icanc0/swarm-pcb/swarm-pcb.kicad_pcb

## KiCad design swarm-pcb.kicad_pcb (2024-11-10)

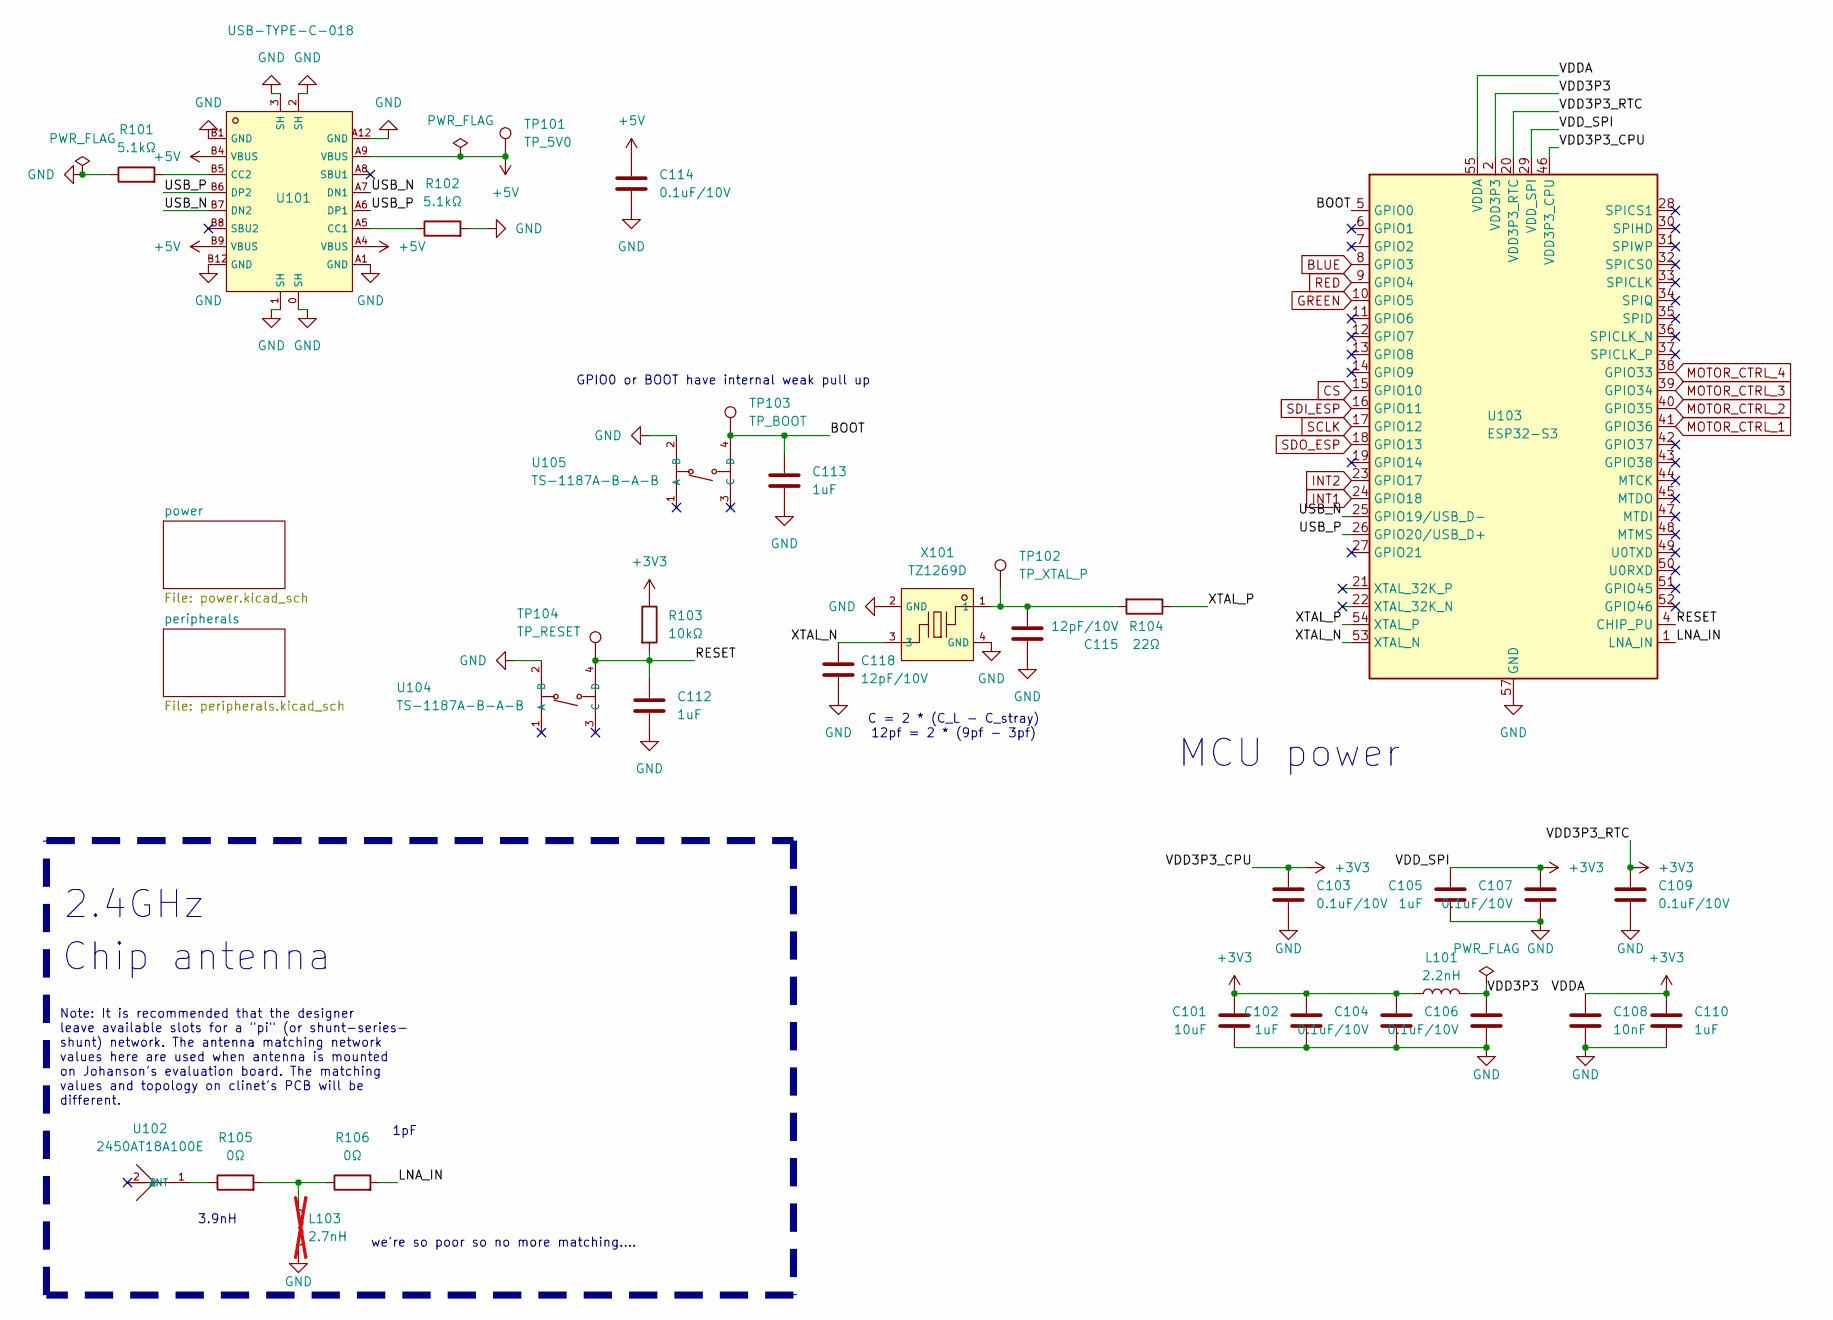
[picture p1: schematic swarm-pcb.kicad_sch]

Parts:
C101: 10uF; C_0603_1608Metric
C102, C105, C110, C112, C113: 1uF; C_0603_1608Metric
C103, C104, C106, C107, C109, C114: 0.1uF/10V; C_0402_1005Metric
C108: 10nF; C_0402_1005Metric
C115, C118: 12pF/10V; C_0603_1608Metric
L101: 2.2nH; L_0402_1005Metric
L103: 2.7nH; L_0402_1005Metric; not fitted
R101, R102: 5.1kΩ; R_0402_1005Metric
R103: 10kΩ; L_0402_1005Metric
R104: 22Ω; R_0402_1005Metric
R105, R106: 0Ω; R_0402_1005Metric
TP101: TP_5V0; Pin_D1.0mm_L10.0mm
TP102: TP_XTAL_P; Pin_D1.0mm_L10.0mm
TP103: TP_BOOT; Pin_D1.0mm_L10.0mm
TP104: TP_RESET; Pin_D1.0mm_L10.0mm
U101: USB-TYPE-C-018; USB-C_SMD-TYPE-C-31-M-12; LCSC C2927038
U102: 2450AT18A100E; ANT-SMD_L3.2-W1.6; LCSC C89334
U103: ESP32-S3; QFN-56-1EP_7x7mm_P0.4mm_EP4x4mm
U104, U105: TS-1187A-B-A-B; SW-SMD_4P-L5.1-W5.1-P3.70-LS6.5-TL-2; LCSC C318884
X101: TZ1269D; CRYSTAL-SMD_4P-L2.0-W1.6-BL-A; LCSC C501798

Connections:
+3V3: C101.1, C102.1, C103.1, C104.1, C105.1, C107.1, C108.1, C109.1, C110.1, L101.2, R103.1, U103.20 (VDD3P3_RTC), U103.29 (VDD_SPI), U103.46 (VDD3P3_CPU), U103.55 (VDDA), U103.56 (VDDA); also elsewhere on the board
+5V: C114.1, TP101.1, U101.A4 (VBUS), U101.A9 (VBUS), U101.B4 (VBUS), U101.B9 (VBUS); also elsewhere on the board
/BOOT: C113.1, TP103.1, U103.5 (GPIO0), U105.4 (D)
/LNA_IN: R106.2, U103.1 (LNA_IN)
/RESET: C112.1, R103.2, TP104.1, U103.4 (CHIP_PU), U104.4 (D)
/USB_N: U101.A7 (DN1), U101.B7 (DN2), U103.25 (GPIO19/USB_D-)
/USB_P: U101.A6 (DP1), U101.B6 (DP2), U103.26 (GPIO20/USB_D+)
/VDD3P3: C106.1, L101.1, U103.2 (VDD3P3), U103.3 (VDD3P3)
/XTAL_N: C118.2, U103.53 (XTAL_N), X101.3
/XTAL_P: R104.1, U103.54 (XTAL_P)
BLUE: U103.8 (GPIO3); also elsewhere on the board
CS: U103.15 (GPIO10); also elsewhere on the board
GND: C101.2, C102.2, C103.2, C104.2, C105.2, C106.2, C107.2, C108.2, C109.2, C110.2, C112.2, C113.2, C114.2, C115.2, C118.1, L103.2, R101.1, R102.2, U101.0 (SH), U101.1 (SH), U101.2 (SH), U101.3 (SH), U101.A1 (GND), U101.A12 (GND), U101.B1 (GND), U101.B12 (GND), U103.57 (GND), U104.2 (B), U105.2 (B), X101.2 (GND), X101.4 (GND); also elsewhere on the board
GREEN: U103.10 (GPIO5); also elsewhere on the board
INT1: U103.24 (GPIO18); also elsewhere on the board
INT2: U103.23 (GPIO17); also elsewhere on the board
MOTOR_CTRL_1: U103.41 (GPIO36); also elsewhere on the board
MOTOR_CTRL_2: U103.40 (GPIO35); also elsewhere on the board
MOTOR_CTRL_3: U103.39 (GPIO34); also elsewhere on the board
MOTOR_CTRL_4: U103.38 (GPIO33); also elsewhere on the board
unnamed: C115.1, R104.2, TP102.1, X101.1
unnamed: L103.1, R105.2, R106.1
unnamed: R102.1, U101.A5 (CC1)
unnamed: R101.2, U101.B5 (CC2)
unnamed: R105.1, U102.1 (ANT)
RED: U103.9 (GPIO4); also elsewhere on the board
SCLK: U103.17 (GPIO12); also elsewhere on the board
SDI_ESP: U103.16 (GPIO11); also elsewhere on the board
SDO_ESP: U103.18 (GPIO13); also elsewhere on the board

Notes on the sheet:
MCU power
2.4GHz
3.9nH
Note: It is recommended that the designer leave available slots for a "pi" (or shunt-series- shunt) network. The antenna matching network values here are used when antenna is mounted on Johanson's evaluation board. The matching values and topology on clinet's PCB will be different.
GPIO0 or BOOT have internal weak pull up
1pF
Chip antenna
we're so poor so no more matching....
C = 2 * (C_L - C_stray) 12pf = 2 * (9pf - 3pf)

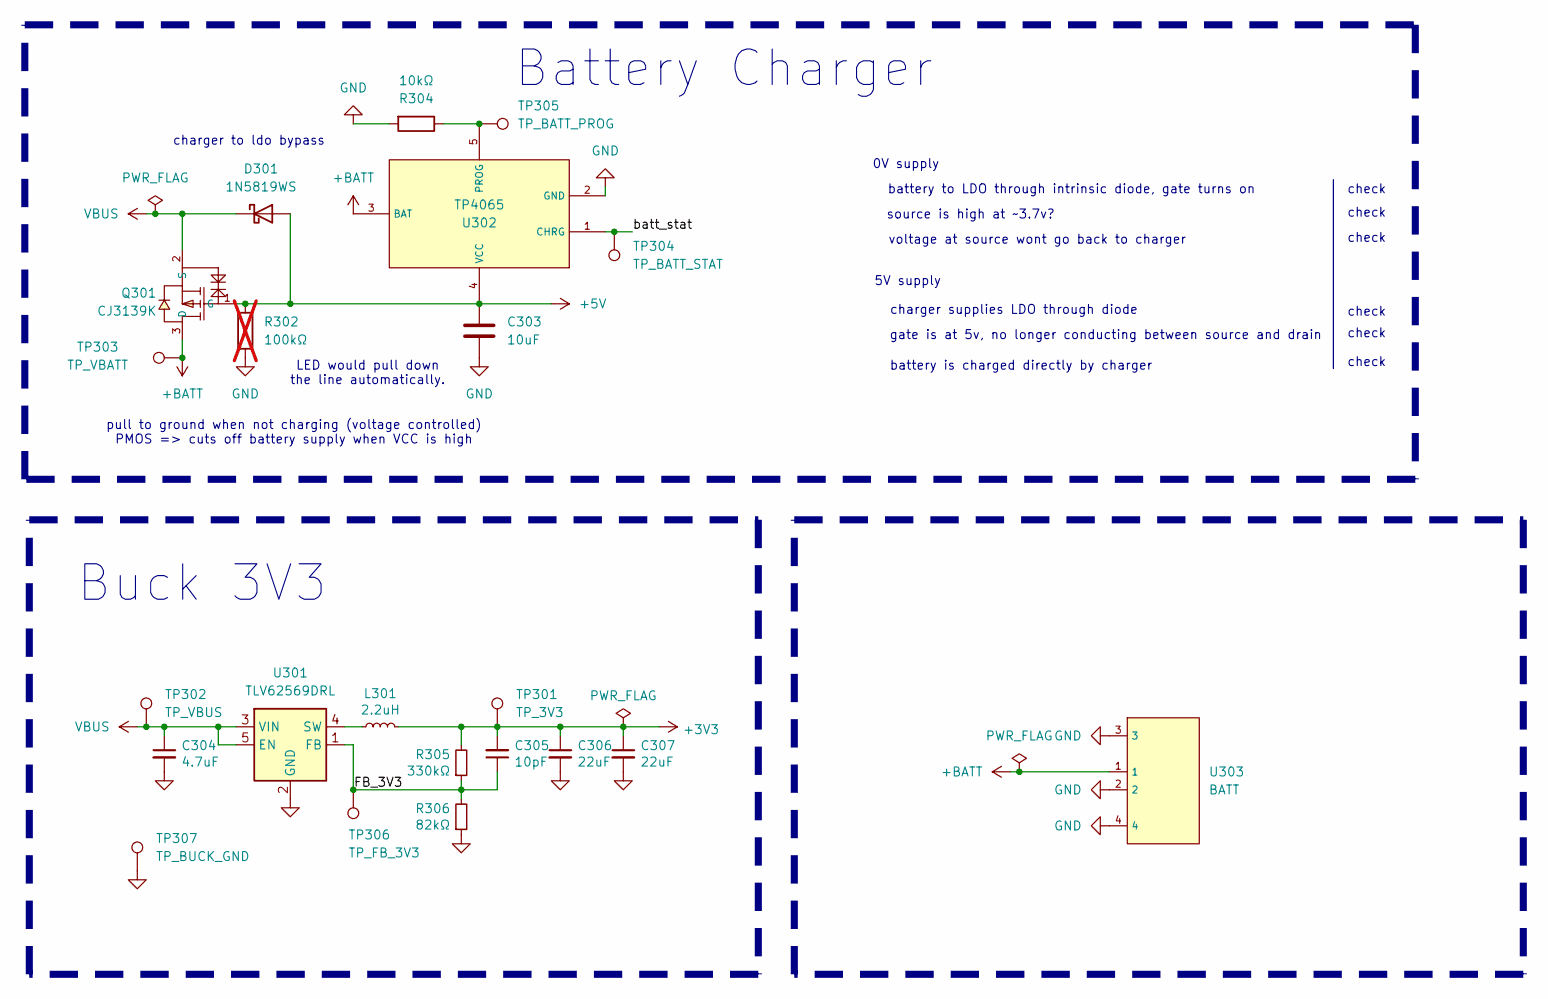
[picture p2: schematic power.kicad_sch]

Parts:
C303: 10uF; C_0603_1608Metric
C304: 4.7uF; C_0603_1608Metric
C305: 10pF; C_0402_1005Metric
C306, C307: 22uF; C_0603_1608Metric
D301: 1N5819WS; D_SOD-323
L301: 2.2uH; IND-SMD_L2.5-W2.0_WPN252012H
Q301: CJ3139K; SOT-723_L1.2-W0.8-P0.40-LS1.2-BR; LCSC C70022
R302: 100kΩ; L_0402_1005Metric; not fitted
R304: 10kΩ; L_0402_1005Metric
R305: 330kΩ; R_0603_1608Metric
R306: 82kΩ; R_0603_1608Metric
TP301: TP_3V3; Pin_D1.0mm_L10.0mm
TP302: TP_VBUS; Pin_D1.0mm_L10.0mm
TP303: TP_VBATT; Pin_D1.0mm_L10.0mm
TP304: TP_BATT_STAT; Pin_D1.0mm_L10.0mm
TP305: TP_BATT_PROG; Pin_D1.0mm_L10.0mm
TP306: TP_FB_3V3; Pin_D1.0mm_L10.0mm
TP307: TP_BUCK_GND; Pin_D1.0mm_L10.0mm
U301: TLV62569DRL; SOT-563
U302: TP4065; SOT-23-5_L3.0-W1.7-P0.95-LS2.8-BR; LCSC C113540
U303: BATT; CONN-TH_BM02B-SRSS-TB-LF-SN; LCSC C160388

Connections:
+3V3: C305.2, C306.1, C307.1, L301.2, R305.2, TP301.1; also elsewhere on the board
+5V: C303.1, D301.2 (A), Q301.1 (G), R302.1, U302.4 (VCC); also elsewhere on the board
+BATT: Q301.3 (D), TP303.1, U302.3 (BAT), U303.1
/power/FB_3V3: C305.1, R305.1, R306.2, TP306.1, U301.1 (FB)
/power/batt_stat: TP304.1, U302.1 (CHRG)
GND: C303.2, C304.2, C306.2, C307.2, R302.2, R304.2, R306.1, TP307.1, U301.2 (GND), U302.2 (GND), U303.2, U303.3, U303.4; also elsewhere on the board
unnamed: L301.1, U301.4 (SW)
unnamed: R304.1, TP305.1, U302.5 (PROG)
VBUS: C304.1, D301.1 (K), Q301.2 (S), TP302.1, U301.3 (VIN), U301.5 (EN)

Notes on the sheet:
check
charger supplies LDO through diode
pull to ground when not charging (voltage controlled) PMOS => cuts off battery supply when VCC is high
0V supply
Buck 3V3
source is high at ~3.7v?
Battery Charger
gate is at 5v, no longer conducting between source and drain
LED would pull down the line automatically.
battery to LDO through intrinsic diode, gate turns on
charger to ldo bypass
battery is charged directly by charger
voltage at source wont go back to charger
5V supply

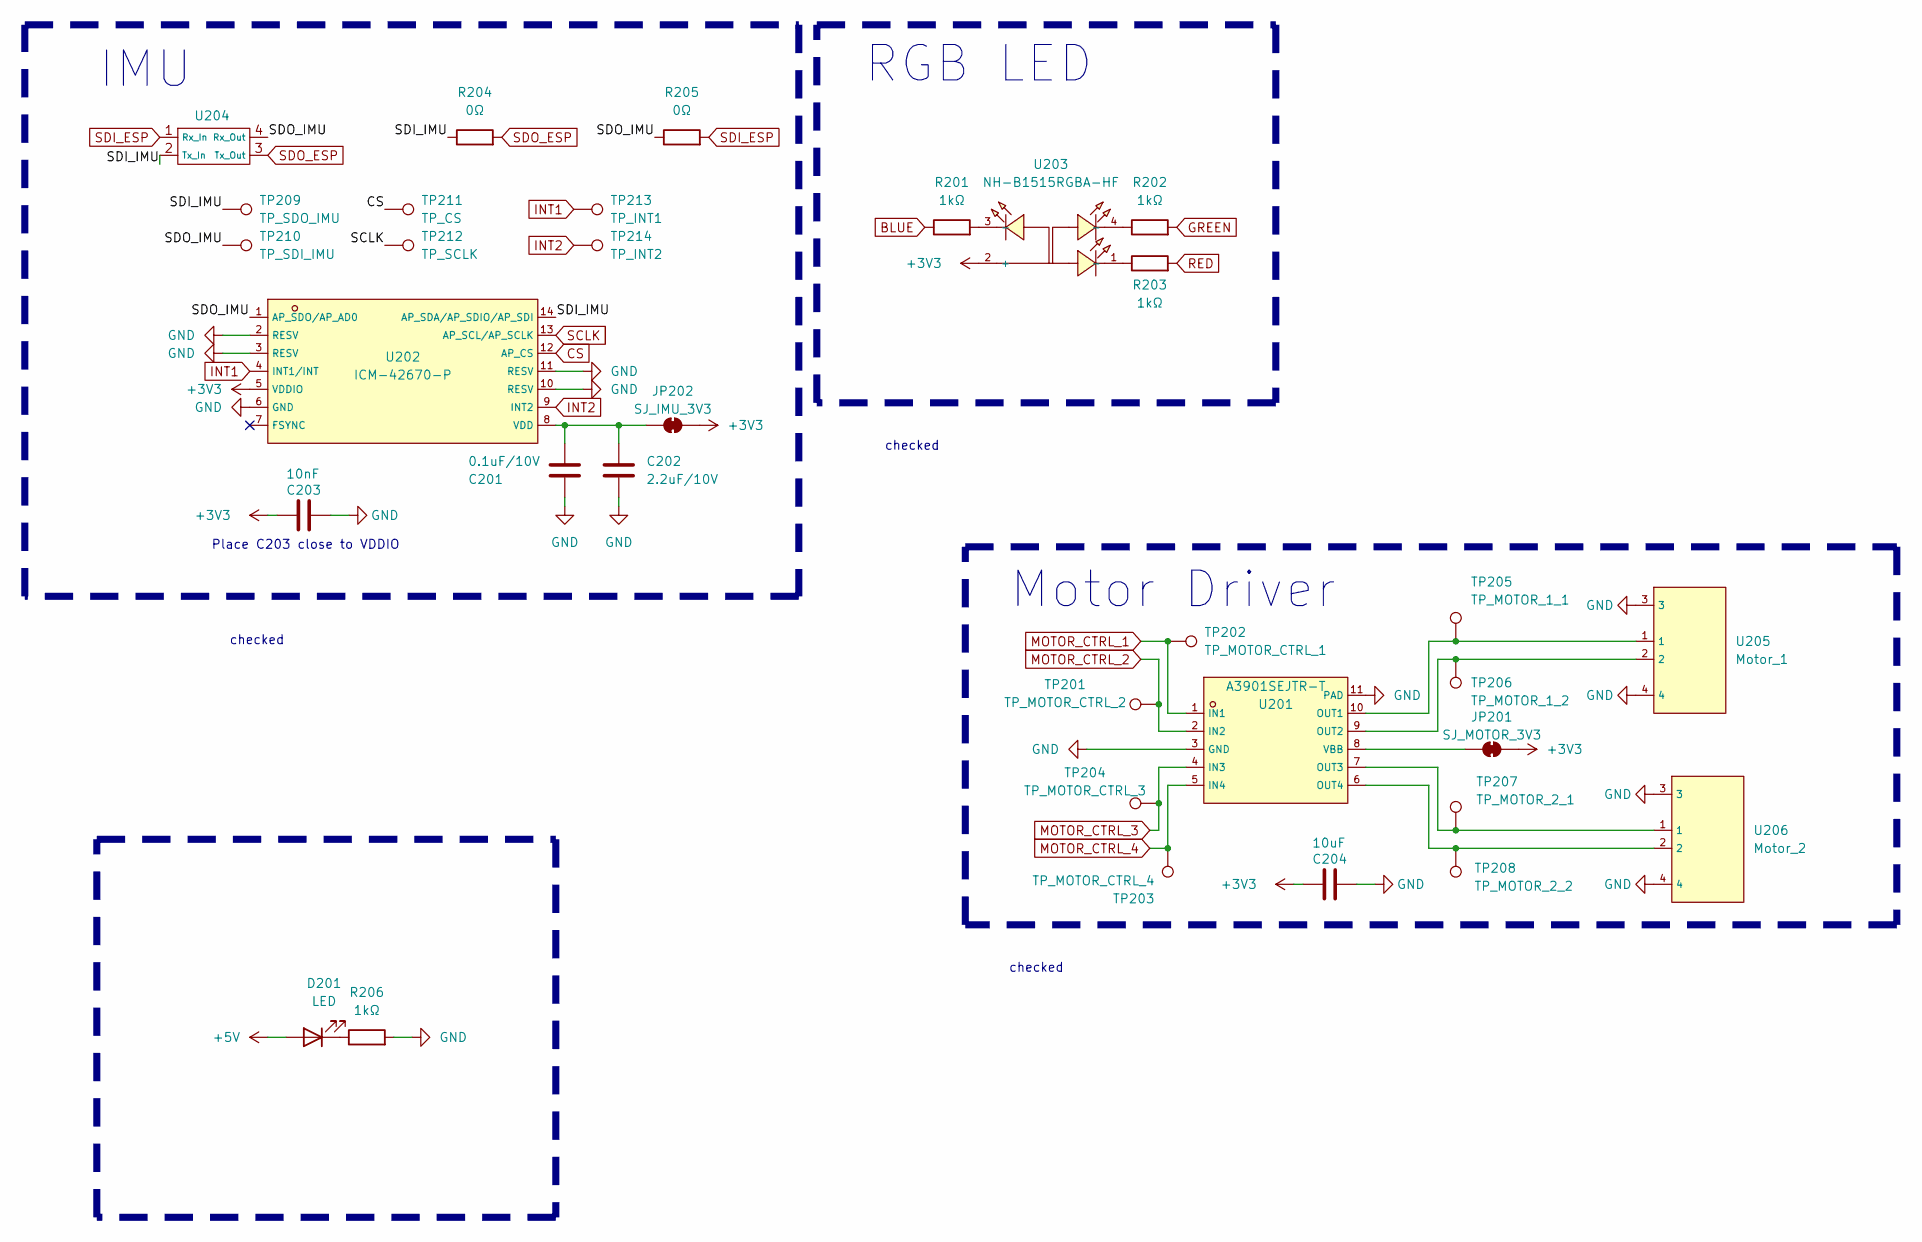
[picture p3: schematic peripherals.kicad_sch]

Parts:
C201: 0.1uF/10V; C_0402_1005Metric
C202: 2.2uF/10V; C_0805_2012Metric
C203: 10nF; C_0402_1005Metric
C204: 10uF; C_0603_1608Metric
D201: LED; LED_0603_1608Metric
JP201: SJ_MOTOR_3V3; SolderJumper-2_P1.3mm_Bridged_RoundedPad1.0x1.5mm
JP202: SJ_IMU_3V3; SolderJumper-2_P1.3mm_Bridged_RoundedPad1.0x1.5mm
R201, R202, R203, R206: 1kΩ; R_0402_1005Metric
R204, R205: 0Ω; R_0603_1608Metric
TP201: TP_MOTOR_CTRL_2; Pin_D1.0mm_L10.0mm
TP202: TP_MOTOR_CTRL_1; Pin_D1.0mm_L10.0mm
TP203: TP_MOTOR_CTRL_4; Pin_D1.0mm_L10.0mm
TP204: TP_MOTOR_CTRL_3; Pin_D1.0mm_L10.0mm
TP205: TP_MOTOR_1_1; Pin_D1.0mm_L10.0mm
TP206: TP_MOTOR_1_2; Pin_D1.0mm_L10.0mm
TP207: TP_MOTOR_2_1; Pin_D1.0mm_L10.0mm
TP208: TP_MOTOR_2_2; Pin_D1.0mm_L10.0mm
TP209: TP_SDO_IMU; Pin_D1.0mm_L10.0mm
TP210: TP_SDI_IMU; Pin_D1.0mm_L10.0mm
TP211: TP_CS; Pin_D1.0mm_L10.0mm
TP212: TP_SCLK; Pin_D1.0mm_L10.0mm
TP213: TP_INT1; Pin_D1.0mm_L10.0mm
TP214: TP_INT2; Pin_D1.0mm_L10.0mm
U201: A3901SEJTR-T; DFN-10_L3.0-W3.0-P0.50-BL-EP; LCSC C146403
U202: ICM-42670-P; LGA-14_L3.0-W2.5-P0.50-TL_QMI8658A; LCSC C3288646
U203: NH-B1515RGBA-HF; LED-ARRAY-SMD_4P-L1.6-W1.5-TL_NH-B1515RGBA; LCSC C2874115
U204: poka-yoke_rxtx
U205: Motor_1; CONN-TH_BM02B-SRSS-TB-LF-SN; LCSC C160388
U206: Motor_2; CONN-TH_BM02B-SRSS-TB-LF-SN; LCSC C160388

Connections:
+3V3: C203.1, C204.1, JP201.2 (B), JP202.2 (B), U202.5 (VDDIO), U203.2 (+); also elsewhere on the board
+5V: D201.2 (A); also elsewhere on the board
/peripherals/SDI_IMU: R204.1, TP209.1, U202.14 (AP_SDA/AP_SDIO/AP_SDI), U204.2 (Tx_In)
/peripherals/SDO_IMU: R205.1, TP210.1, U202.1 (AP_SDO/AP_AD0), U204.4 (Rx_Out)
BLUE: R201.1; also elsewhere on the board
CS: TP211.1, U202.12 (AP_CS); also elsewhere on the board
GND: C201.2, C202.2, C203.2, C204.2, R206.2, U201.3 (GND), U201.11 (PAD), U202.2 (RESV), U202.3 (RESV), U202.6 (GND), U202.10 (RESV), U202.11 (RESV), U205.3, U205.4, U206.3, U206.4; also elsewhere on the board
GREEN: R202.2; also elsewhere on the board
INT1: TP213.1, U202.4 (INT1/INT); also elsewhere on the board
INT2: TP214.1, U202.9 (INT2); also elsewhere on the board
MOTOR_CTRL_1: TP202.1, U201.1 (IN1); also elsewhere on the board
MOTOR_CTRL_2: TP201.1, U201.2 (IN2); also elsewhere on the board
MOTOR_CTRL_3: TP204.1, U201.4 (IN3); also elsewhere on the board
MOTOR_CTRL_4: TP203.1, U201.5 (IN4); also elsewhere on the board
unnamed: D201.1 (K), R206.1
unnamed: JP201.1 (A), U201.8 (VBB)
unnamed: C201.1, C202.1, JP202.1 (A), U202.8 (VDD)
unnamed: R201.2, U203.3 (-)
unnamed: R202.1, U203.4 (-)
unnamed: R203.1, U203.1 (-)
unnamed: TP205.1, U201.10 (OUT1), U205.1
unnamed: TP206.1, U201.9 (OUT2), U205.2
unnamed: TP207.1, U201.7 (OUT3), U206.1
unnamed: TP208.1, U201.6 (OUT4), U206.2
RED: R203.2; also elsewhere on the board
SCLK: TP212.1, U202.13 (AP_SCL/AP_SCLK); also elsewhere on the board
SDI_ESP: R205.2, U204.1 (Rx_In); also elsewhere on the board
SDO_ESP: R204.2, U204.3 (Tx_Out); also elsewhere on the board

Notes on the sheet:
checked
Motor Driver
IMU
Place C203 close to VDDIO
RGB LED

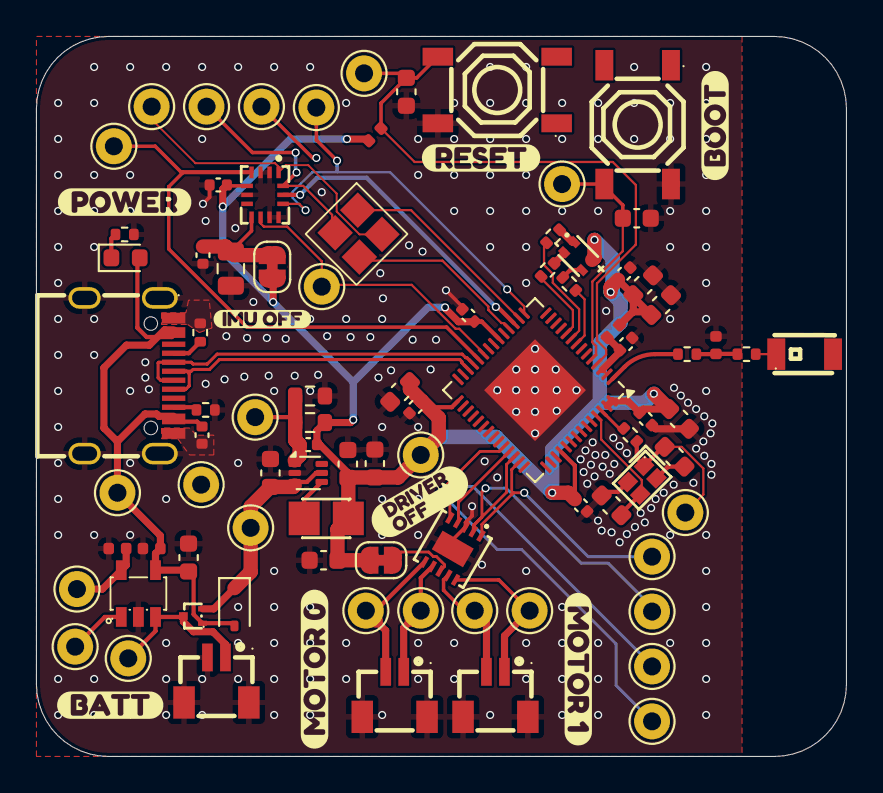
[picture p4: board swarm-pcb.kicad_pcb from above]

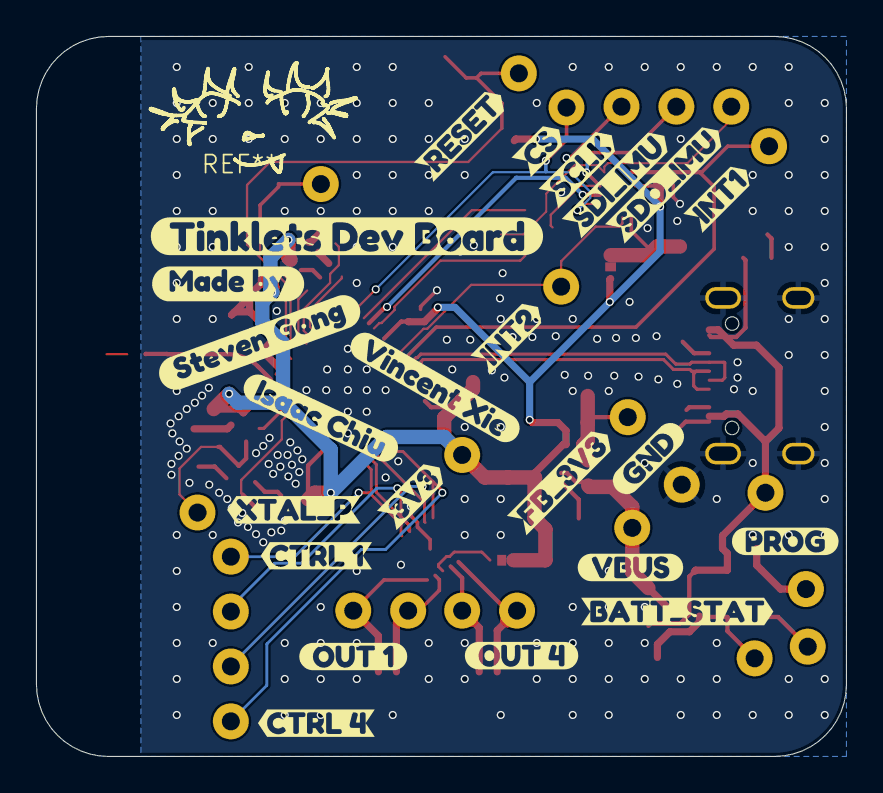
[picture p5: board swarm-pcb.kicad_pcb from below]

Board: 4 copper layers, 45.0 x 40.0 mm, 119 parts (23 on the bottom side), 47 nets.

Other parts of the board:
kibuzzard-672F6F41: G***; kibuzzard-672F6F41
kibuzzard-672F6FA2: G***; kibuzzard-672F6FA2
kibuzzard-672F6FAB: G***; kibuzzard-672F6FAB
kibuzzard-672F6FBA: G***; kibuzzard-672F6FBA
kibuzzard-672F6FFE: G***; kibuzzard-672F6FFE
kibuzzard-672F708E: G***; kibuzzard-672F708E
kibuzzard-672F7049: G***; kibuzzard-672F7049
kibuzzard-672F7060: G***; kibuzzard-672F7060
kibuzzard-673054F1: G***; kibuzzard-673054F1
kibuzzard-673055BA: G***; kibuzzard-673055BA
kibuzzard-673055CB: G***; kibuzzard-673055CB
kibuzzard-673055DA: G***; kibuzzard-673055DA
kibuzzard-673055F3: G***; kibuzzard-673055F3
kibuzzard-673055FE: G***; kibuzzard-673055FE
kibuzzard-673056FB: G***; kibuzzard-673056FB
kibuzzard-6730551F: G***; kibuzzard-6730551F
kibuzzard-6730552C: G***; kibuzzard-6730552C
kibuzzard-6730556D: G***; kibuzzard-6730556D
kibuzzard-6730559C: G***; kibuzzard-6730559C
kibuzzard-6730560C: G***; kibuzzard-6730560C
kibuzzard-6730561B: G***; kibuzzard-6730561B
kibuzzard-6730566E: G***; kibuzzard-6730566E
kibuzzard-6730568D: G***; kibuzzard-6730568D
kibuzzard-67305501: G***; kibuzzard-67305501
kibuzzard-67305511: G***; kibuzzard-67305511
kibuzzard-67305534: G***; kibuzzard-67305534
kibuzzard-67305547: G***; kibuzzard-67305547
kibuzzard-67305558: G***; kibuzzard-67305558
kibuzzard-67305590: G***; kibuzzard-67305590
kibuzzard-67305712: G***; kibuzzard-67305712
kibuzzard-67305722: G***; kibuzzard-67305722
