icanc0/swarm-pcb/(commit log)

2024-11-09 added test points
    [peripherals.kicad_sch, power.kicad_sch, swarm-pcb.kicad_pcb, swarm-pcb.kicad_sch]
2024-11-10 production time
    [peripherals.kicad_sch, power.kicad_sch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]
